PUT-Motorsport/PUTM_EV_CAN_Translator/hardware/Can_EngineTranslator.kicad_pcb

## KiCad design hardware/Can_EngineTranslator.kicad_pcb (2021-06-22)

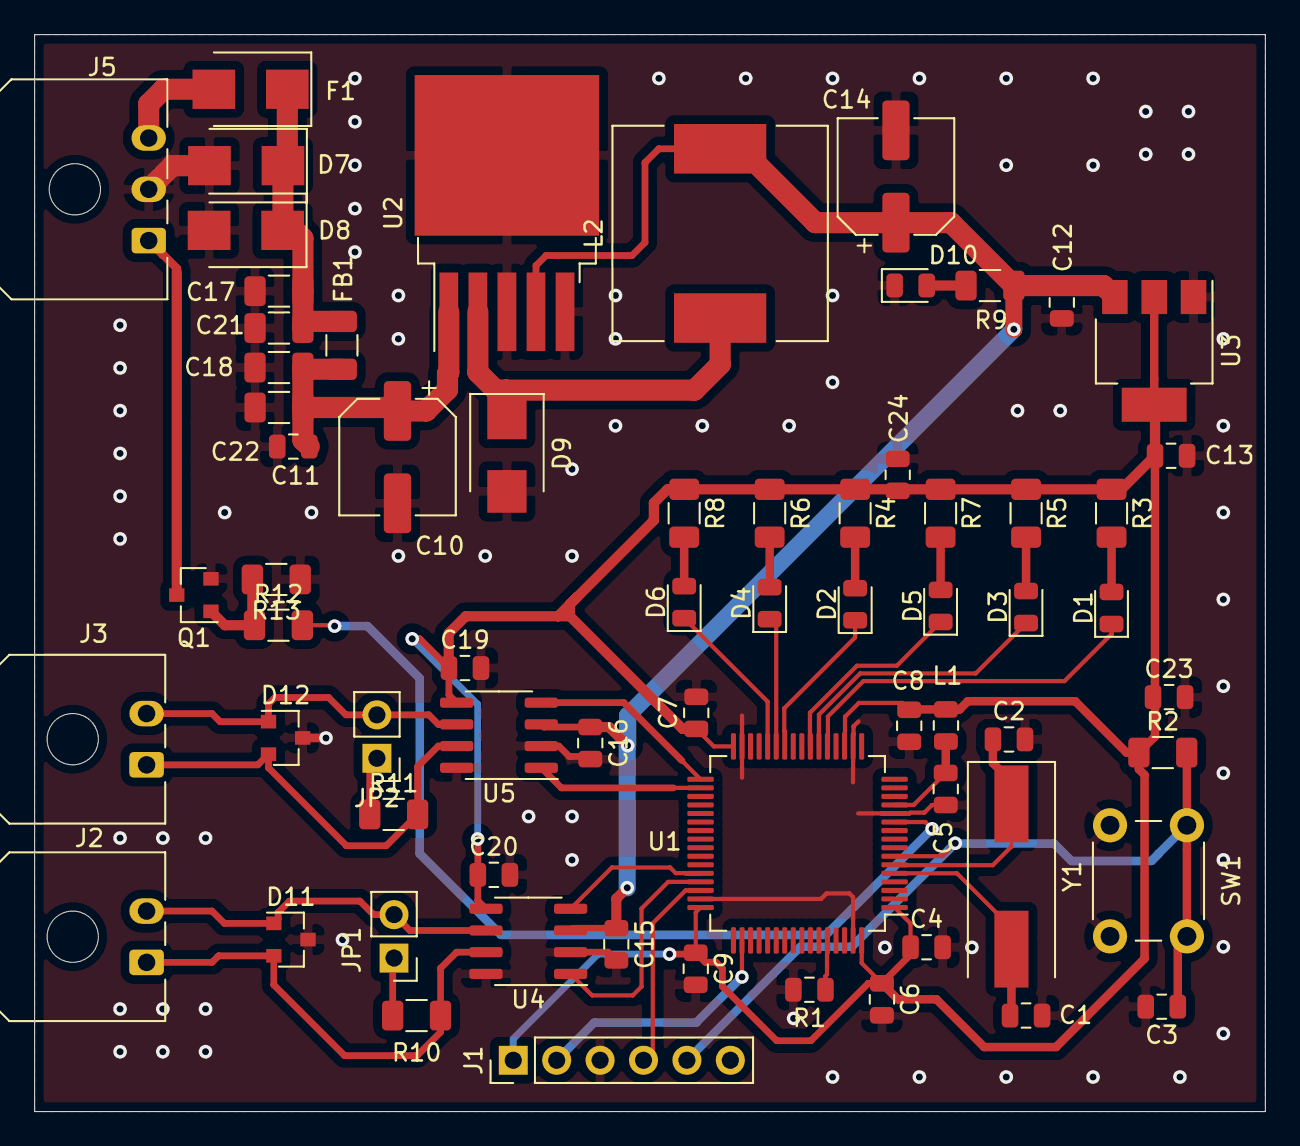
[picture p1: board Can_EngineTranslator.kicad_pcb from above]

Board: 2 copper layers, 72.0 x 63.0 mm, 67 parts (0 on the bottom side), 40 nets.

Parts:
C1, C2: 22pF; C_0805_2012Metric
C3, C4, C5, C6, C7, C8, C9, C11, C12, C13, C15, C16, C19, C20, C23, C24: 100nF; C_0805_2012Metric
C10: 680uF; CP_Elec_6.3x7.7
C14: 220u; CP_Elec_6.3x7.7
C17, C18, C21, C22: CP_Small; C_1206_3216Metric
D1, D2, D3, D4, D5, D6, D10: LED; LED_0805_2012Metric
D7: 1SMA5937BT3G; D_SMB
D8, D9: SS24T3G; D_SMB
D11, D12: PESD2CAN.215; SOT-23
F1: Polyfuse; D_SMB
FB1: Ferrite_Bead_Small; R_1206_3216Metric
J1: ProgramerConnector; PinHeader_1x06_P2.54mm_Vertical
J2: CANcarConnector; Molex_Micro-Fit_3.0_43650-0200_1x02_P3.00mm_Horizontal
J3: CANinverterConnector; Molex_Micro-Fit_3.0_43650-0200_1x02_P3.00mm_Horizontal
J5: PowerOutputConnector; Molex_Micro-Fit_3.0_43650-0300_1x03_P3.00mm_Horizontal
JP1, JP2: Jumper; PinHeader_1x02_P2.54mm_Vertical
L1: L; L_0805_2012Metric
L2: 33u; L_12x12mm_H8mm
Q1: BSS138; SOT-23
R1: 100k; R_0805_2012Metric
R2, R13: 10k; R_1206_3216Metric
R3, R4, R5, R6, R7, R8, R9: 180; R_1206_3216Metric
R10, R11: 120R; R_1206_3216Metric
R12: 100; R_1206_3216Metric
SW1: SW_Push; SW_PUSH_6mm
U1: STM32F105RBTx; LQFP-64_10x10mm_P0.5mm
U2: LM2596S-5; TO-263-5_TabPin3
U3: LM1117-3.3; SOT-223-3_TabPin2
U4, U5: MCP2562-H-SN; SOIC-8_3.9x4.9mm_P1.27mm
Y1: Crystal 8 MHz; Crystal_SMD_HC49-SD

Connections:
+5V: C12.1, C14.1, C15.1, C16.1, L2.2, R9.1, U2.4, U3.3, U4.3, U5.3
CANcar_H: D11.2, J2.1, R10.2, U4.7
CANcar_L: D11.1, J2.2, JP1.2, U4.6
CANcar_RX: U1.44, U4.4
CANcar_TX: U1.45, U4.1
CANinverter_H: D12.2, J3.1, R11.2, U5.7
CANinverter_L: D12.1, J3.2, JP2.2, U5.6
CANinverter_RX: U1.33, U5.4
CANinverter_TX: U1.34, U5.1
NRST: C3.1, J1.5, R2.2, SW1.2, U1.7
unnamed: C1.1, U1.5, Y1.2
unnamed: C2.1, U1.6, Y1.1
unnamed: C5.1, L1.2, U1.13
unnamed: C10.1, C11.1, C18.1, C22.1, FB1.2, U2.1
unnamed: C17.1, C21.1, D7.1, D8.1, F1.1, FB1.1
unnamed: D1.1, U1.21
unnamed: D1.2, R3.2
unnamed: D2.1, U1.26
unnamed: D2.2, R4.2
unnamed: D3.1, U1.22
unnamed: D3.2, R5.2
unnamed: D4.1, U1.27
unnamed: D4.2, R6.2
unnamed: D5.1, U1.23
unnamed: D5.2, R7.2
unnamed: D6.1, U1.28
unnamed: D6.2, R8.2
unnamed: D9.1, L2.1, U2.2
unnamed: D10.2, R9.2
unnamed: JP1.1, R10.1
unnamed: JP2.1, R11.1
unnamed: Q1.1, R12.1, R13.2
unnamed: R1.1, U1.60
SWCLK: J1.2, U1.50
SWDIO: J1.4, U1.46
SW_GND: C1.2, C2.2, C3.2, C4.2, C5.2, C6.2, C7.2, C8.2, C9.2, C10.2, C11.2, C12.2, C13.2, C14.2, C15.2, C16.2, C17.2, C18.2, C19.2, C20.2, C21.2, C22.2, C23.2, C24.2, D7.2, D8.2, D9.2, D10.1, D11.3, D12.3, J1.3, J5.2, Q1.2, R1.2, R13.1, SW1.1, U1.12, U1.18, U1.31, U1.47, U1.63, U2.3, U2.5, U3.1, U4.2, U4.8, U5.2, U5.8
SW_VDDtarget: C4.1, C6.1, C7.1, C8.1, C9.1, C13.1, C19.1, C20.1, C23.1, C24.1, J1.1, L1.1, R2.1, R3.1, R4.1, R5.1, R6.1, R7.1, R8.1, U1.1, U1.19, U1.32, U1.48, U1.64, U3.2, U4.5, U5.5
VCC: F1.2, J5.3
buzzer: R12.2, U1.11
buzzer_gnd: J5.1, Q1.3
