PUT-Motorsport/PUTM_EV_CAN_Translator/(threads)

Thread 4 (2021-05-11):

Detect TS on

KwiatPiotr, 2021-05-11:
CAN translator has to detect if driver switch TS's switch and enable inverter to move the motor.

Closed 2021-05-16.

Thread 5 (2021-05-11):

Send torque commands only when TS is on

KwiatPiotr, 2021-05-11:
CAN Translator should send torque commands only when TS in activated. In other case no command should be send beside requests for information.

KwiatPiotr, 2021-05-16:
Done it in [here](https://github.com/PUT-Motorsport/PUTM_EV_CAN_Translator/issues/4). Need test

KwiatPiotr, 2021-07-05:
OK

Closed 2021-07-05.
