PUT-Motorsport/PUTM_EV_CAN_Translator/PUTM_EV_CAN_Translator_f105/Core/Src/main.c

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
/* Includes ------------------------------------------------------------------*/
#include "main.h"

/* USER CODE BEGIN Includes */
#include "can_messeges_func.h"
#include "inverter_register_codes.h"
#include "common.h"

/* USER CODE END Includes */

CAN_HandleTypeDef hcan1;
CAN_HandleTypeDef hcan2;

TIM_HandleTypeDef htim2;
TIM_HandleTypeDef htim3;

/* USER CODE BEGIN PV */
CAN_FilterTypeDef sFilterConfig;

CAN_RxHeaderTypeDef RxHeader_CAN1;
CAN_RxHeaderTypeDef RxHeader_CAN2;

uint8_t RxData_CAN1[8];
uint8_t RxData_CAN2[8];

uint32_t TxMailbox1;
uint32_t TxMailbox2;

uint16_t inverter_RPM;
uint16_t inverter_RPM_to_send;
uint16_t inverter_RMS;
uint16_t inverter_status;
uint8_t inverter_temp_IGBT;
uint8_t inverter_temp_engine;
uint16_t inverter_temp_IGBT_raw;
uint16_t inverter_temp_engine_raw;
uint16_t inverter_temp_air_raw;

uint16_t inverter_RPM_N_MAX;
uint16_t inverter_RPM_LIMIT;

const uint16_t inverter_igbt_temp_table[21] = {17151, 17400, 17688, 18017, 18387, 18979,
                                         19247, 19733, 20250, 20793, 21357, 21933, 22515, 23097,
                                         23671, 24232, 24775, 25296, 25792, 26261, 26702};

const uint16_t inverter_engine_temp_table[15] = {8438, 8971, 9510, 10052, 10592, 11128,
                                           11662, 12192, 12714, 13228, 13735, 14228, 14685, 15082, 15397};

typedef void (*request_list_type)(CAN_TxHeaderTypeDef *, uint8_t **);

uint32_t tim2_counter;
uint32_t last_apps_timestamp;
uint32_t apps_timeout_counter;
uint32_t engine_timeout_counter;

uint8_t send_inverter_data;
uint8_t send_apps_data;
uint8_t inverter_stopped;
uint8_t send_stop_limit;
uint8_t send_stop_N_max;

uint16_t apps_to_send = 0;
uint8_t TS_state = 0;
uint8_t RTDS_enable = 0;
uint16_t RTDS_counter = 0;
uint32_t RTDS_timestamp = 0;

/* USER CODE END PV */

void SystemClock_Config(void);

static void MX_GPIO_Init(void);

static void MX_CAN1_Init(void);

static void MX_CAN2_Init(void);

static void MX_TIM2_Init(void);

static void MX_TIM3_Init(void);

/* USER CODE BEGIN PFP */
static void my_init(void);

static void CAN_requests_Init(void);

static void my_init_CAN(void);

/* USER CODE END PFP */

/**
  * @brief  The application entry point.
  * @retval int
  */
int main(void) {
    /* MCU Configuration--------------------------------------------------------*/

    /* Reset of all peripherals, Initializes the Flash interface and the Systick. */
    HAL_Init();

    /* Configure the system clock */
    SystemClock_Config();

    /* Initialize all configured peripherals */
    MX_GPIO_Init();
    MX_CAN1_Init();
    MX_CAN2_Init();
    MX_TIM2_Init();
    MX_TIM3_Init();
    /* USER CODE BEGIN 2 */

    HAL_Delay(500);

    my_init();

    HAL_TIM_Base_Start_IT(&htim2);
    HAL_TIM_Base_Start_IT(&htim3);

    CAN_TxHeaderTypeDef tx_header_inverter_data;
    uint8_t inverter_data[8] = {0, 0, 0, 0, 0, 0, 0, 0};
    tx_header_inverter_data.StdId = INVERTER_MESS_ID;
    tx_header_inverter_data.RTR = CAN_RTR_DATA;
    tx_header_inverter_data.IDE = CAN_ID_STD;
    tx_header_inverter_data.DLC = INVERTER_MESS_DLC;
    tx_header_inverter_data.TransmitGlobalTime = DISABLE;
    uint32_t mail_data_inverter = 0;

    /* USER CODE END 2 */

    /* Infinite loop */
    /* USER CODE BEGIN WHILE */
    while (1) {
        /* USER CODE END WHILE */

        /* USER CODE BEGIN 3 */
        if (send_apps_data >= SEND_APPS_INTERVAL && TS_state && !inverter_stopped) {
            send_apps_data = 0;

            if (apps_to_send > 0) {
                apps_to_send = ((apps_to_send * TORQUE_MULTIPLIER) / TORQUE_DIVIDER);
            }
            else if (apps_to_send == 0 && inverter_RPM_to_send > 0) {
                apps_to_send = 0;
                //apps = -10;		// -2.5%
                //apps = -50;		// -5%
                //apps = -1 * (inverter_RPM_to_send * 10 / 0x7fff);

				//TODO
				//add function to calculate reverse torque to slow car down
				//test:
				//	- use constant torque
				//	- use function (linear or not)
            }

            CAN_TxHeaderTypeDef TxHeader;
            uint8_t TxData[3];
            CAN_set_speed_command(&TxHeader, TxData, apps_to_send);

            HAL_CAN_AbortTxRequest(&hcan2, TxMailbox2);
            if (HAL_CAN_AddTxMessage(&hcan2, &TxHeader, TxData, &TxMailbox2) != HAL_OK) {
                Error_Handler();
            }
        }

        if (send_inverter_data && !inverter_stopped) {
            inverter_temp_IGBT = calculate_IGBT_temperature(inverter_temp_IGBT_raw);
            inverter_temp_engine = calculate_engine_temperature(inverter_temp_engine_raw);
            uint16_t inverter_status_to_send = inverter_status;
            uint16_t inverter_RMS_to_sent = inverter_RMS;

            if (inverter_RPM_LIMIT == 0 && inverter_RPM_N_MAX == 0) {
                inverter_RPM_to_send = 0x7FFF;
            }
            else {
                inverter_RPM_to_send = (uint16_t) ((float) inverter_RPM / 32767.0f * (float) inverter_RPM_N_MAX);
            }

            inverter_data[0] = (uint8_t) (inverter_RPM_to_send & 0x00FF);
            inverter_data[1] = (uint8_t) (inverter_RPM_to_send >> 8);
            inverter_data[2] = (uint8_t) (inverter_RMS_to_sent & 0xFF);
            inverter_data[3] = (uint8_t) (inverter_RMS_to_sent >> 8);
            inverter_data[4] = (uint8_t) (inverter_status_to_send & 0xFF);
            inverter_data[5] = (uint8_t) (inverter_status_to_send >> 8);
            inverter_data[6] = inverter_temp_engine;
            inverter_data[7] = inverter_temp_IGBT;

            if (HAL_CAN_AddTxMessage(&hcan1, &tx_header_inverter_data, inverter_data, &mail_data_inverter) != HAL_OK) {
                Error_Handler();
            }
            send_inverter_data = 0;
        }

        if (send_stop_N_max && !inverter_stopped) {
            CAN_TxHeaderTypeDef tx_header_inverter_stop_N_max;
            uint8_t inverter_data_stop_max[3];
            uint32_t mail_data_inverter_stop_max = 0;

            CAN_stop_speed_limit_command(&tx_header_inverter_stop_N_max, inverter_data_stop_max);

            HAL_CAN_AddTxMessage(&hcan2, &tx_header_inverter_stop_N_max, inverter_data_stop_max,
                                 &mail_data_inverter_stop_max);
            while (HAL_CAN_IsTxMessagePending(&hcan2, mail_data_inverter_stop_max));
        }

        if (send_stop_limit && !inverter_stopped) {
            CAN_TxHeaderTypeDef tx_header_inverter_stop_limit;
            uint8_t inverter_data_stop_limit[3];
            uint32_t mail_data_inverter_stop_limit = 0;

            CAN_stop_speed_limit_command(&tx_header_inverter_stop_limit, inverter_data_stop_limit);

            HAL_CAN_AddTxMessage(&hcan2, &tx_header_inverter_stop_limit, inverter_data_stop_limit,
                                 &mail_data_inverter_stop_limit);
            while (HAL_CAN_IsTxMessagePending(&hcan2, mail_data_inverter_stop_limit));
        }

        if (inverter_stopped == 1) {
            CAN_TxHeaderTypeDef TxHeader_inverter_stopped;
            uint8_t TxData[2] = {INVERTER_ERROR_DATA, INVERTER_ERROR_DATA};
            TxHeader_inverter_stopped.StdId = INVERTER_ERROR_ID;
            TxHeader_inverter_stopped.IDE = CAN_ID_STD;
            TxHeader_inverter_stopped.RTR = CAN_RTR_DATA;
            TxHeader_inverter_stopped.TransmitGlobalTime = DISABLE;
            TxHeader_inverter_stopped.DLC = INVERTER_ERROR_DLC;

            HAL_CAN_AddTxMessage(&hcan1, &TxHeader_inverter_stopped, TxData, &TxMailbox1);
            HAL_Delay(10);
        }

        if (RTDS_enable) {
            HAL_GPIO_WritePin(RTDS_GPIO_Port, RTDS_Pin, GPIO_PIN_SET);
            HAL_GPIO_WritePin(GPIO_LED_1_GPIO_Port, GPIO_LED_1_Pin, GPIO_PIN_RESET);
        }

        if (!RTDS_enable) {
            HAL_GPIO_WritePin(RTDS_GPIO_Port, RTDS_Pin, GPIO_PIN_RESET);
            HAL_GPIO_WritePin(GPIO_LED_1_GPIO_Port, GPIO_LED_1_Pin, GPIO_PIN_SET);
        }
    }
    /* USER CODE END 3 */
}

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
/* USER CODE BEGIN 4 */
static void my_init(void) {
    inverter_RPM_to_send = 0;
    inverter_RPM_N_MAX = 0;
    inverter_RPM_LIMIT = 0;

    tim2_counter = 0;
    apps_timeout_counter = 0;
    engine_timeout_counter = 0;

    send_inverter_data = 0;

    my_init_CAN();

    CAN_requests_Init();

    HAL_GPIO_WritePin(GPIO_LED_1_GPIO_Port, GPIO_LED_1_Pin, 1);
    HAL_GPIO_WritePin(GPIO_LED_2_GPIO_Port, GPIO_LED_2_Pin, 1);
    HAL_GPIO_WritePin(GPIO_LED_3_GPIO_Port, GPIO_LED_3_Pin, 1);
    HAL_GPIO_WritePin(GPIO_LED_4_GPIO_Port, GPIO_LED_4_Pin, 1);
    HAL_GPIO_WritePin(GPIO_LED_5_GPIO_Port, GPIO_LED_5_Pin, 1);
    HAL_GPIO_WritePin(GPIO_LED_6_GPIO_Port, GPIO_LED_6_Pin, 1);
}

static void CAN_requests_Init(void) {
    request_list_type requests[5] = {
            &CAN_request_speed_command,
            &CAN_request_igbt_temp_command,
            &CAN_request_motor_temp_command,
            &CAN_request_N_max_command,
            &CAN_request_speed_limit_command
    };

    for (int i = 0; i < 5; ++i) {
        CAN_TxHeaderTypeDef TxHeader;
        uint8_t *TxData = NULL;

        requests[i](&TxHeader, &TxData);

        if (HAL_CAN_AddTxMessage(&hcan2, &TxHeader, TxData, &TxMailbox2) != HAL_OK) {
            Error_Handler();
        }

        while (HAL_CAN_IsTxMessagePending(&hcan2, TxMailbox2));

        HAL_Delay(3);
        free(TxData);
    }

    HAL_Delay(10);
}

static void my_init_CAN(void) {
    sFilterConfig.FilterBank = 15;
    sFilterConfig.FilterMode = CAN_FILTERMODE_IDMASK;
    sFilterConfig.FilterScale = CAN_FILTERSCALE_32BIT;
    sFilterConfig.FilterIdHigh = 0x0000;
    sFilterConfig.FilterIdLow = 0x0000;
    sFilterConfig.FilterMaskIdHigh = 0x0;
    sFilterConfig.FilterMaskIdLow = 0x0;
    sFilterConfig.FilterFIFOAssignment = CAN_RX_FIFO0;
    sFilterConfig.FilterActivation = ENABLE;
    sFilterConfig.SlaveStartFilterBank = 14;



    if (HAL_CAN_ConfigFilter(&hcan1, &sFilterConfig) != HAL_OK) {
        Error_Handler();
    }

    if (HAL_CAN_ConfigFilter(&hcan2, &sFilterConfig) != HAL_OK) {
        Error_Handler();
    }

    if (HAL_CAN_Start(&hcan1) != HAL_OK) {
        Error_Handler();
    }

    if (HAL_CAN_Start(&hcan2) != HAL_OK) {
        Error_Handler();
    }

    if (HAL_CAN_ActivateNotification(&hcan1, CAN_IT_RX_FIFO0_MSG_PENDING | CAN_IT_TX_MAILBOX_EMPTY) != HAL_OK) {
        Error_Handler();
    }

    if (HAL_CAN_ActivateNotification(&hcan2, CAN_IT_RX_FIFO0_MSG_PENDING | CAN_IT_TX_MAILBOX_EMPTY) != HAL_OK) {
        Error_Handler();
    }
}
/* USER CODE END 4 */
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
