PUT-Motorsport/PUTM_EV_CAN_Translator/PUTM_EV_CAN_Translator_f105/PUTM_EV_CAN_Translator_f105.ioc

Mcu.UserName=STM32F105RBTx
PA11.Signal=CAN1_RX
PA12.Signal=CAN1_TX
PA13.Signal=SYS_JTMS-SWDIO
PA14.Signal=SYS_JTCK-SWCLK
PA5.GPIO_Label=GPIO_LED_1
PA5.Signal=GPIO_Output
PA6.GPIO_Label=GPIO_LED_2
PA6.Signal=GPIO_Output
PA7.GPIO_Label=GPIO_LED_3
PA7.Signal=GPIO_Output
PB12.Signal=CAN2_RX
PB13.Signal=CAN2_TX
PB6.Signal=USART1_TX
PB7.Signal=USART1_RX
PC3.GPIO_Label=RTDS
PC3.Signal=GPIO_Output
PC7.GPIO_Label=GPIO_LED_4
PC7.Signal=GPIO_Output
PC8.GPIO_Label=GPIO_LED_5
PC8.Signal=GPIO_Output
PC9.GPIO_Label=GPIO_LED_6
PC9.Signal=GPIO_Output
PD0-OSC_IN.Signal=RCC_OSC_IN
PD1-OSC_OUT.Signal=RCC_OSC_OUT
