PUT-Motorsport/PUTM_EV_CAN_Translator/PUTM_EV_CAN_Translator_f105/Core/Inc/main.h

#define RTDS_Pin GPIO_PIN_3
#define RTDS_GPIO_Port GPIOC
#define GPIO_LED_1_Pin GPIO_PIN_5
#define GPIO_LED_1_GPIO_Port GPIOA
#define GPIO_LED_2_Pin GPIO_PIN_6
#define GPIO_LED_2_GPIO_Port GPIOA
#define GPIO_LED_3_Pin GPIO_PIN_7
#define GPIO_LED_3_GPIO_Port GPIOA
#define GPIO_LED_4_Pin GPIO_PIN_7
#define GPIO_LED_4_GPIO_Port GPIOC
#define GPIO_LED_5_Pin GPIO_PIN_8
#define GPIO_LED_5_GPIO_Port GPIOC
#define GPIO_LED_6_Pin GPIO_PIN_9
#define GPIO_LED_6_GPIO_Port GPIOC
