PUT-Motorsport/PUTM_EV_CAN_Translator/PUTM_EV_CAN_Translator_f105/Core/Src/can_messeges_func.c

#include "can_messeges_func.h"
#include "inverter_register_codes.h"

uint16_t MAX_SPEED = 32767;

extern uint16_t inverter_igbt_temp_table[];
extern uint16_t inverter_engine_temp_table[];

void CAN_disable_controller_command(CAN_TxHeaderTypeDef *TxHeader, uint8_t *TxData) {
    TxHeader->StdId = TRANSMIT_DATA_ID;
    TxHeader->RTR = CAN_RTR_DATA;
    TxHeader->IDE = CAN_ID_STD;
    TxHeader->DLC = 3;
    TxHeader->TransmitGlobalTime = DISABLE;

    TxData[0] = 0x51;
    TxData[1] = 0x04;
    TxData[2] = 0x00;
}

void CAN_set_speed_command(CAN_TxHeaderTypeDef *TxHeader, uint8_t *TxData, uint16_t apps) {
/*
     * apps 1 => 0.2% speed
     * apps 2 => 0.4% speed
     * apps 3 => 0.6% speed
     * apps 4 => 0.8% speed
     * apps 5 => 1.0% speed
     * apps 10 => 2.0% speed
     * apps 50 => 10.0% speed
     */

    TxHeader->StdId = TRANSMIT_DATA_ID;
    TxHeader->RTR = CAN_RTR_DATA;
    TxHeader->IDE = CAN_ID_STD;
    TxHeader->DLC = 3;
    TxHeader->TransmitGlobalTime = DISABLE;

    TxData[0] = TORQUE_SETPOI;

    int16_t val = (MAX_SPEED / 500) * apps;
    TxData[1] = (int8_t)(val & 0x00FF);
    TxData[2] = (int8_t)(val >> 8);
}

void CAN_stop_speed_command(CAN_TxHeaderTypeDef *TxHeader, uint8_t *TxData) {
    TxHeader->StdId = TRANSMIT_DATA_ID;
    TxHeader->RTR = CAN_RTR_DATA;
    TxHeader->IDE = CAN_ID_STD;
    TxHeader->DLC = 3;
    TxHeader->TransmitGlobalTime = DISABLE;

    TxData[0] = SPEED_SOLL;
    TxData[1] = 0x00;
    TxData[2] = 0x00;
}

void CAN_request_speed_command(CAN_TxHeaderTypeDef *TxHeader, uint8_t **TxData) {
    TxHeader->StdId = TRANSMIT_DATA_ID;
    TxHeader->RTR = CAN_RTR_DATA;
    TxHeader->IDE = CAN_ID_STD;
    TxHeader->DLC = 3;
    TxHeader->TransmitGlobalTime = DISABLE;

    (*TxData) = malloc(3 * sizeof(uint8_t));

    (*TxData)[0] = READ_COMMAND;
    (*TxData)[1] = SPEED_ACTUAL_;
    (*TxData)[2] = 0x0A;
}

void CAN_request_igbt_temp_command(CAN_TxHeaderTypeDef *TxHeader, uint8_t **TxData) {
    TxHeader->StdId = TRANSMIT_DATA_ID;
    TxHeader->RTR = CAN_RTR_DATA;
    TxHeader->IDE = CAN_ID_STD;
    TxHeader->DLC = 3;
    TxHeader->TransmitGlobalTime = DISABLE;

    (*TxData) = malloc(3 * sizeof(uint8_t));

    (*TxData)[0] = READ_COMMAND;
    (*TxData)[1] = T_IGBT;
    (*TxData)[2] = 0x0A;
}

void CAN_request_motor_temp_command(CAN_TxHeaderTypeDef *TxHeader, uint8_t **TxData) {
    TxHeader->StdId = TRANSMIT_DATA_ID;
    TxHeader->RTR = CAN_RTR_DATA;
    TxHeader->IDE = CAN_ID_STD;
    TxHeader->DLC = 3;
    TxHeader->TransmitGlobalTime = DISABLE;

    (*TxData) = malloc(3 * sizeof(uint8_t));

    (*TxData)[0] = READ_COMMAND;
    (*TxData)[1] = T_MOTOR;
    (*TxData)[2] = 0x0A;
}

void CAN_request_N_max_command(CAN_TxHeaderTypeDef *TxHeader, uint8_t **TxData) {
    TxHeader->StdId = TRANSMIT_DATA_ID;
    TxHeader->RTR = CAN_RTR_DATA;
    TxHeader->IDE = CAN_ID_STD;
    TxHeader->DLC = 3;
    TxHeader->TransmitGlobalTime = DISABLE;

    (*TxData) = malloc(3 * sizeof(uint8_t));

    (*TxData)[0] = READ_COMMAND;
    (*TxData)[1] = MOTOR_RPMMAX;
    (*TxData)[2] = 0x0A;
}

void CAN_request_speed_limit_command(CAN_TxHeaderTypeDef *TxHeader, uint8_t **TxData) {
    TxHeader->StdId = TRANSMIT_DATA_ID;
    TxHeader->RTR = CAN_RTR_DATA;
    TxHeader->IDE = CAN_ID_STD;
    TxHeader->DLC = 3;
    TxHeader->TransmitGlobalTime = DISABLE;

    (*TxData) = malloc(3 * sizeof(uint8_t));

    (*TxData)[0] = READ_COMMAND;
    (*TxData)[1] = SPEED_LIMIT;
    (*TxData)[2] = 0x0A;
}

void CAN_stop_speed_limit_command(CAN_TxHeaderTypeDef *TxHeader, uint8_t *TxData) {
    TxHeader->StdId = TRANSMIT_DATA_ID;
    TxHeader->RTR = CAN_RTR_DATA;
    TxHeader->IDE = CAN_ID_STD;
    TxHeader->DLC = 3;
    TxHeader->TransmitGlobalTime = DISABLE;

    TxData[0] = READ_COMMAND;
    TxData[1] = SPEED_LIMIT;
    TxData[2] = 0xFF;
}

uint8_t calculate_IGBT_temperature(uint16_t val) {
    uint8_t res = 0xFF;
    uint8_t i = 0;

    while (val >= inverter_igbt_temp_table[i] && i < 20) {
        i++;
    }

    if (i == 20) {
        return res;
    }

    float x = (float) (inverter_igbt_temp_table[i] - inverter_igbt_temp_table[i - 1]);
    float y = (float) (val - inverter_igbt_temp_table[i - 1]);

    res = (uint8_t)(((i - 1) * 5.0) + (y * 5.0 / x));
    return res;
}

uint8_t calculate_engine_temperature(uint16_t val) {
    uint8_t res = 0xFF;
    uint8_t i = 0;

    while (val >= inverter_engine_temp_table[i] && i < 14) {
        i++;
    }

    if (i == 14) {
        return res;
    }

    float x = (float) (inverter_engine_temp_table[i] - inverter_engine_temp_table[i - 1]);
    float y = (float) (val - inverter_engine_temp_table[i - 1]);
    res = (uint8_t)(((i - 1) * 10.0) + (y * 10.0 / x));

    return res;
}
