PUT-Motorsport/PUTM_EV_CAN_Translator/PUTM_EV_CAN_Translator_f105/Core/Inc/inverter_register_codes.h

/*
 * inverter_register_codes.h
 *
 *  Created on: Oct 25, 2020
 *      Author: kwitnoncy
 */

#ifndef INC_INVERTER_REGISTER_CODES_H_
#define INC_INVERTER_REGISTER_CODES_H_

#define SEND_APPS_INTERVAL 100

#define STATUS			0x40
#define READ_COMMAND    0x3D

#define SPEED_FILTER_ 	0x5E	// tested
#define SPEED_ACTUAL 	0x30	// tested
#define SPEED_ACTUAL_	0xA8	// tested works
#define MOTOR_RPMMAX	0x59	// tested works
#define SPEED_LIMIT		0x34	// tested works

#define SPEED_SOLL		0x31	// tested works
#define TORQUE_SETPOI	0x90	// tested works

#define I_IST_FILT		0x5F
#define T_IGBT			0x4A	// tested works
#define T_MOTOR			0x49	// tested works
#define T_AIR			0x4B	// tested works

#define TRANSMIT_DATA_ID	0x201
#define RECEIVE_DATA_ID 	0x181

#endif /* INC_INVERTER_REGISTER_CODES_H_ */
