PUT-Motorsport/PUTM_EV_CAN_Translator/(commit log)

2020-10-06 Something test, send data from inverter, repair hardware. Stick to your guns.
    [CAN.sch, Can_EngineTranslator.kicad_pcb, Can_EngineTranslator.sch, PowerModule.sch, _saved_CanModules.sch, _saved_STM.sch]
2020-10-06 All features. To test and adjust timers
2020-10-31 Current working version.
2021-05-02 Files changed to actual version
    [CAN.sch, Can_EngineTranslator.csv, Can_EngineTranslator.kicad_pcb, Can_EngineTranslator.sch, PowerModule.sch]
2021-05-02 PCB Fixed
    [CAN.sch, Can_EngineTranslator.kicad_pcb, Can_EngineTranslator.sch, PowerModule.sch]
2021-05-02 Checked MJ
    [CAN.sch, Can_EngineTranslator.kicad_pcb, Can_EngineTranslator.sch, PowerModule.sch]
2021-05-10 Sync with Podio
    [CAN.sch, Can_EngineTranslator.csv, Can_EngineTranslator.kicad_pcb, Can_EngineTranslator.sch, PowerModule.sch]
2021-05-10 Connector change
    [Can_EngineTranslator.kicad_pcb]
2021-05-10 Cosmetic changes to pcb
    [Can_EngineTranslator.kicad_pcb]
2021-05-16 fixed merging bug, added common.h for macros
    [common.h, main.c]
2021-05-16 Transmit torque only when TS is ON
2021-05-19 No torque transmission when APPS or inverter does not response
2021-05-19 Release update
    [Can_EngineTranslator.kicad_pcb]
2021-06-22 reapired pcb
    [Can_EngineTranslator.kicad_pcb]
2021-07-06 Added ts on/off functionality, change CAN ID, RTDS duration, CAN filters
2021-08-01 deleted CAN filters
